Jathurshan0330/Hand_gesture_controlled_Robot/Circuit Designs Prothesus/Receiver.PNG

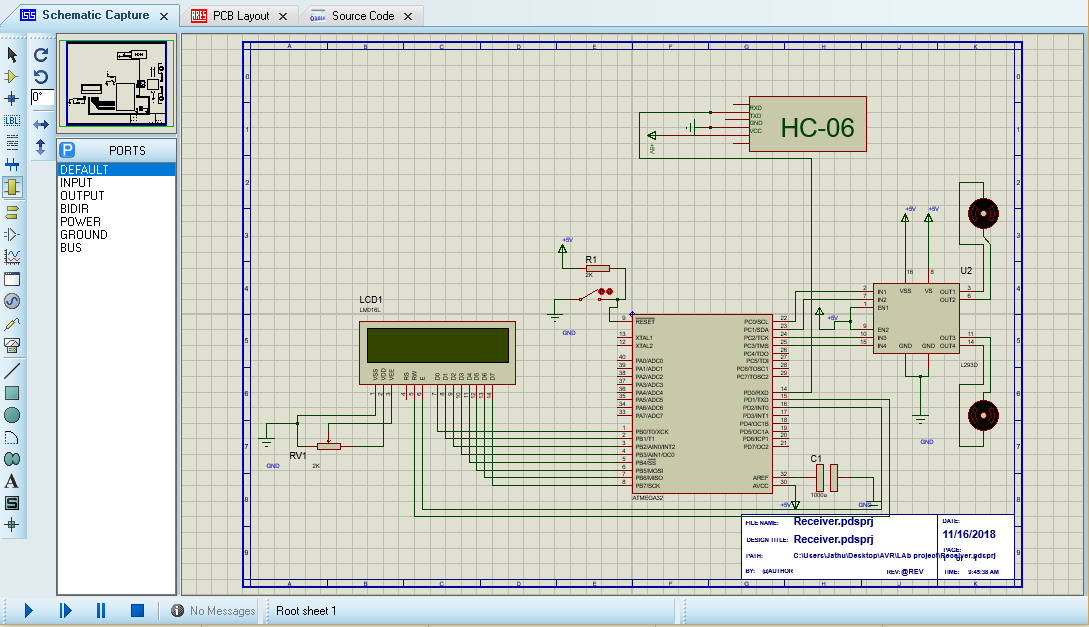
Circuit Designs Prothesus/Receiver.PNG
