Jathurshan0330/Hand_gesture_controlled_Robot/Circuit Designs Prothesus/Transmitter.PNG

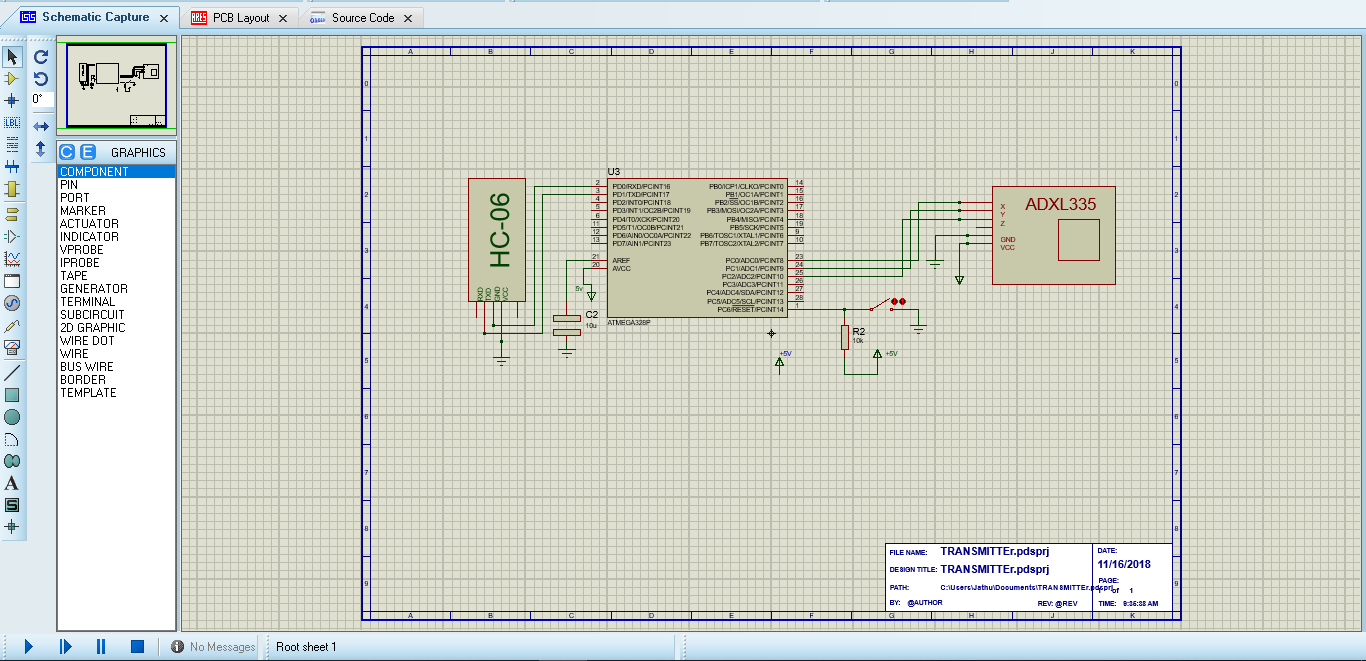
Circuit Designs Prothesus/Transmitter.PNG
