Jathurshan0330/Hand_gesture_controlled_Robot/(list of files, drawings)

Other design files:
Circuit Designs Prothesus/Hand gesture controlled vehicle.pdsprj
Circuit Designs Prothesus/Receiver.pdsprj
Circuit Designs Prothesus/TRANSMITTEr.pdsprj
